craigyjp/Voice_board_analogue_6_channel/schematics/Controller.pdf

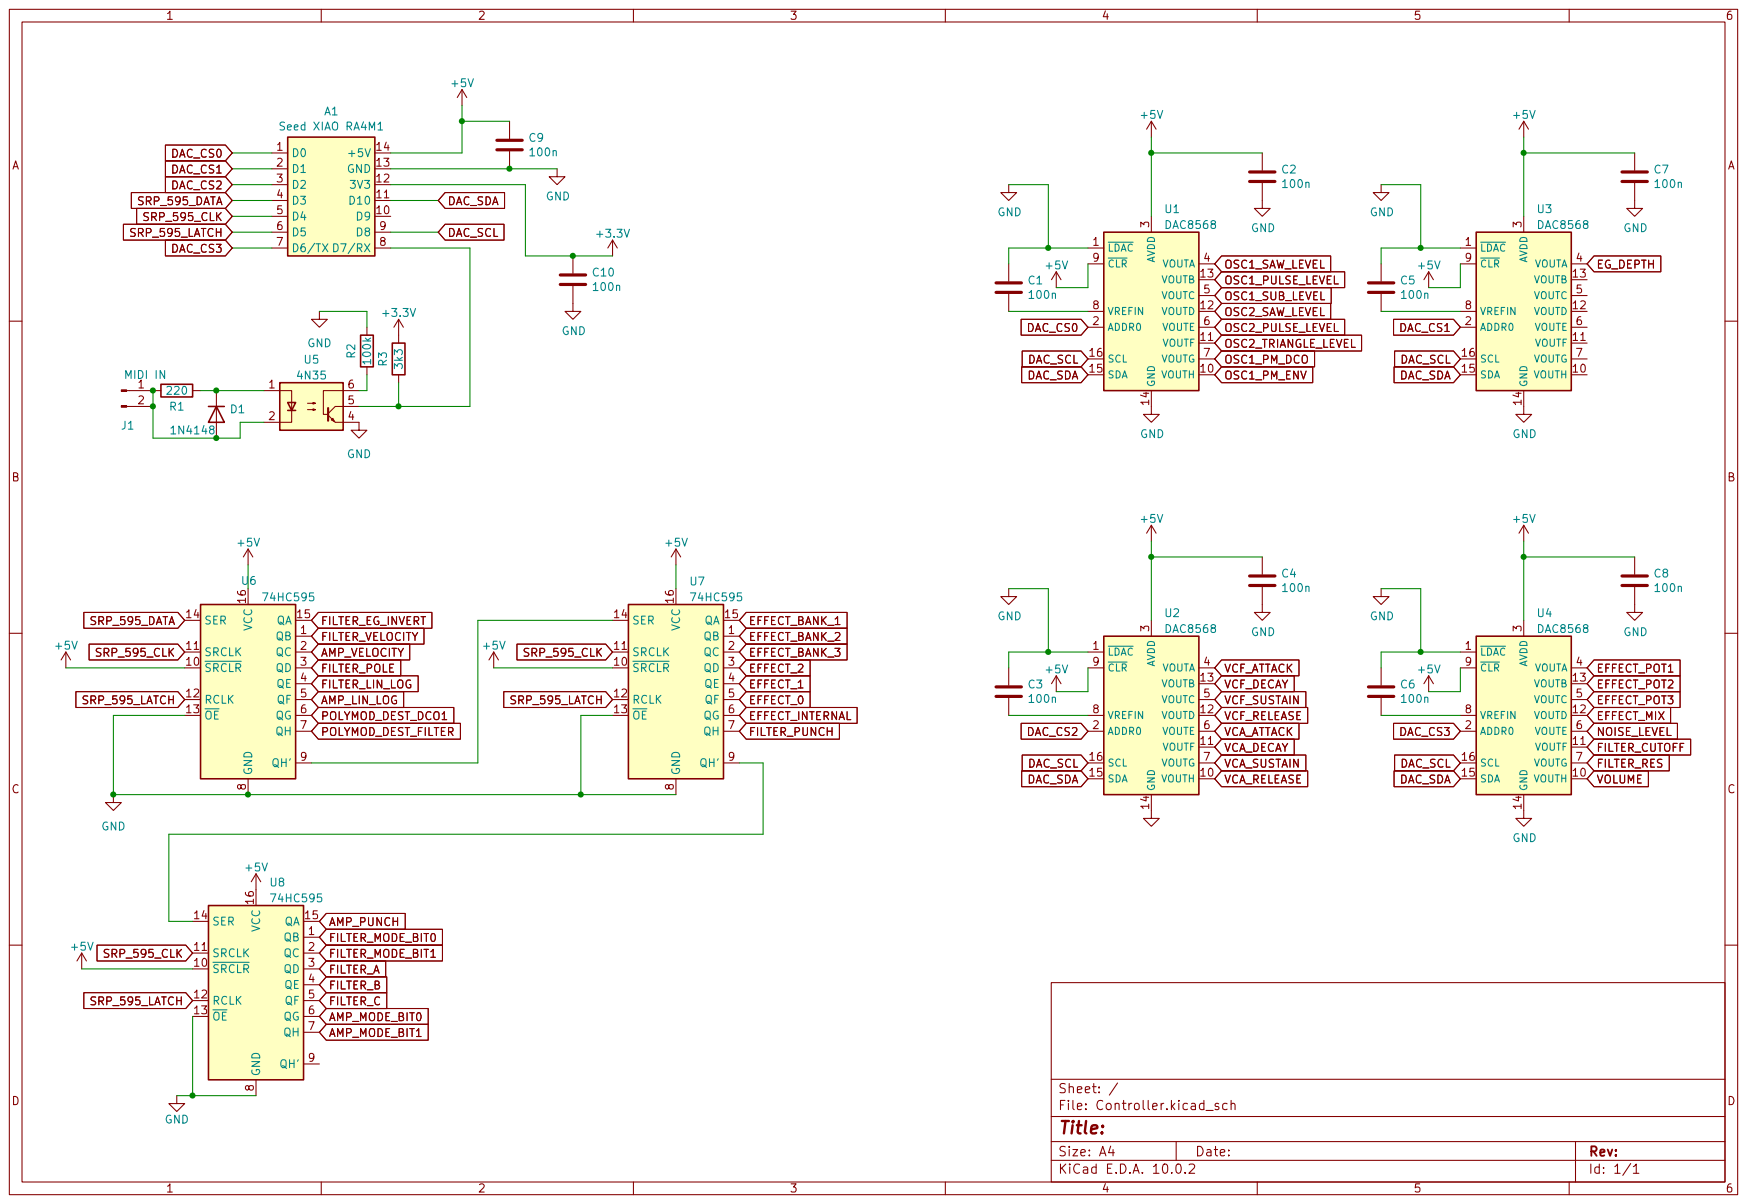
[picture p2: page 1]
